MaxKiv/hhh/(commit log)

2025-05-19 feat(schematic): add kicad schematic
    [Mockloop_Schematic.kicad_pcb, Mockloop_Schematic.kicad_sch]
2025-05-28 feat(kicad): update mockloop schematic
    [Mockloop_Schematic.kicad_sch]
2026-05-11 chore: update submodules, organise schematics
    [Mockloop_Schematic.kicad_pcb, Mockloop_Schematic.kicad_sch]
2026-05-11 feat(schematic): analog_frontend schematic
    [analog_frontend.kicad_pcb, analog_frontend.kicad_sch, mockloop_electronics.kicad_pcb, mockloop_electronics.kicad_sch]
2026-05-12 feat: update schematics
    [Mockloop_Schematic.kicad_pcb, Mockloop_Schematic.kicad_sch, analog_converter_board.kicad_sch, analog_frontend.kicad_sch, control_box.kicad_pcb, control_box.kicad_sch]
2026-05-26 feat: update hhh control box schematic
    [control_box.kicad_sch]
